JamesTipton/WordClock/Design/Word Clock.xlsx

Sheet: LED Words
Word | Length | Series Voltage | Lights | LED Chip Code | 2 LED | 3 LED | 4 LED | RGB Words | Lights
One | 3 | 8.1 | 3 | 0x00 04 00 00 00 00 |  | 1 |  | Happy | 5
Two | 3 | 8.1 | 3 | 0x00 00 04 00 00 00 |  | 1 |  | Birthday | 8
Three | 5 | 13.5 | 5 | 0x00 00 10 00 00 01 | 1 | 1 |  | Michael | 7
Four | 4 | 10.8 | 4 | 0x00 00 00 00 04 00 |  |  | 1 | Channels | LEDs | Current Draw (@20mA)
Fivebot | 4 | 10.8 | 4 | 0x00 00 00 00 20 00 |  |  | 1 | 3 | 20 | 0.4
Six | 3 | 8.1 | 3 | 0x00 02 00 00 00 00 |  | 1
Seven | 5 | 13.5 | 5 | 0x00 20 00 00 00 02 | 1 | 1
Eight | 5 | 13.5 | 5 | 0x00 08 00 00 00 04 | 1 | 1
Nine | 4 | 10.8 | 4 | 0x00 00 00 00 01 00 |  |  | 1
Tenbot | 3 | 8.1 | 3 | 0x00 00 08 00 00 00 |  | 1
Eleven | 6 | 16.2 | 6 | 0x00 10 20 00 00 00 |  | 2
Twelve | 6 | 16.2 | 6 | 0x00 00 42 00 00 00 |  | 2 |  | TLC5916 Parameters
Oclock | 6 | 16.2 | 6 | 0x00 80 01 00 00 00 |  | 2 |  | Vdd | 5 | V
It Is | 4 | 10.8 | 4 | 0x00 00 00 02 00 00 |  |  | 1 | Vg | 0.992
Tentop | 3 | 8.1 | 3 | 0x00 01 00 00 00 00 |  | 1 |  | CM | 1
Half | 4 | 10.8 | 4 | 0x00 00 00 00 40 00 |  |  | 1 | Io | 0.03 | A
A Quarter | 8 | 21.6 | 8 | 0x00 00 00 01 80 00 |  |  | 2 | Rext | 625 | Ohms
Twenty | 6 | 16.2 | 6 | 0x00 40 80 00 00 00 |  | 2
Fivetop | 4 | 10.8 | 4 | 0x00 00 00 00 02 00 |  |  | 1
Minutes | 7 | 18.9 | 7 | 0x01 00 00 00 10 00 |  | 1 | 1
Past | 4 | 10.8 | 4 | 0x00 00 00 00 08 00 |  |  | 1
To | 2 | 5.4 | 2 | 0x00 00 00 00 00 08 | 1
V Drop Per LED | 2.7 | 7.29 | 99 | Channels | 4 | 17 | 10
Total Words | 22 | Total Channels | 31 | Chips | 1 | 3 | 2
Pinout MSB
Pin | 3LED3 | 3LED2 | 3LED1 | 4LED2 | 4LED1 | 2LED | 48 bits
0 | TES | TENtop | OCL | AQUA | NINE | EE
1 | 0 | SIX | LVE | IT IS | FIVEtop | EN
2 | 0 | ONE | TWO | 0 | FOUR | HT
3 | 0 | EIG | TENbot | 0 | PAST | TO
4 | 0 | ELE | THR | 0 | MINU | 0
5 | 0 | SEV | VEN | 0 | FIVEbot | 0
6 | 0 | TWEtop | TWEbot | 0 | HALF | 0
7 | 0 | OCK | NTY | 0 | RTER | 0
2.833333333

Sheet: Parts List
Nomenclature | Qty | Total Cost | Part Number | Source | Cost Each | Vendor PN | Vendor
Arduino Uno | 1 | 24.95 | Arduino Uno R3 | sparkfun.com | 24.95 | DEV-11021 | Arduino
8 Ch SPI Control LED Driver | 6 | 9.9 | 296-24383-5-ND | digikey.com | 1.65 | TLC5916IN | TI | x
White Clear LED 5mm | 120 | 26.4 |  | evilmadscientist.com | 0.22 | BL-L513UWC | Betlux Electronics
RGB Addressable, PTH | 5 | 14.75 | COM-12999 | sparkfun.com | 2.95 | APA-106-F5 | sparkfun.com
Momentary Pushbutton - White | 4 | 19.8 | COM-11967 | sparkfun.com | 4.95 | COM-11967 | sparkfun.com
Real Time Clock | 1 | 6.03 | DS1305+-ND | digikey.com | 6.03 | DS1305+ | Maxim Integrated | x
32.768kHz Quartz Oscillator | 1 | 0.3 | 728-1000-ND | digikey.com | 0.3 | VT200F-6PF20PPM | Seiko Instruments | x
620 Ohm 2W Resistor | 6 | 1.74 | 620W-2-ND | digikey.com | 0.29 | RSF200JB-73-620R | Yageo | x
12V to 9V Regulator | 1 | 0.7 | LM7809ACT-ND | digikey.com | 0.7 | LM7809ACT | Fairchild Semiconductor | x
12V to 5V Regulator | 1 | 10.84 | 102-2188-ND | digikey.com | 10.84 | V7805-2000R | CUI Inc
12V - 2A Wall Plug | 1 | 13.6 | T1071-P5P-ND | digikey.com | 13.6 | EPSA120200U-P5P-SZ | CUI Inc | x
DC power Plug | 1 | 1.79 | CP3-002AH-ND | digikey.com | 1.79 | PP3-002AH | CUI Inc | x
DC Power Jack | 1 | 2.84 | CP-024A-ND | digikey.com | 2.84 | PR-002A | CUI Inc | x
Capacitor 0.33 uF | 2 | 0.5 | 493-10465-1-ND | digikey.com | 0.25 | UMA1HR33MDD1TP | Nichicon
Capacitor 0.1 uF | 2 | 1.06 | 493-10331-1-ND | digikey.com | 0.53 | UMV1H0R1MFD1TP | Nichicon
Capacitor 1000 uF | 1 | 0.33 | 493-1467-ND | digikey.com | 0.33 | UHE0J102MPD | Nichicon
Coin Battery Holder for RTC - CR2032 Size | 1 | 0.64 | 952-1737-1-ND | digikey.com | 0.64 | S8421-45R | Harwin Inc | x
10k Ohm Resistor | 10 | 0.8 | CF14JT10K0CT-ND | digikey.com | 0.08 | CF14JT10K0 | Stackpole Electronics | x
420 Ohm Resistor | 10 | 1 | CF14JT200RCT-ND | digikey.com | 0.1 | CF14JT200R | Stackpole Electronics
3V Coin Batt for RTC - CR2032 | 1 | 0.28 | P189-ND | digikey.com | 0.28 | CR2032 | Panasonic
1x6 0.1" Pin Header | 2 | 0.84 | 3M9451-ND | digikey.com | 0.42
2x7 0.1" DIP Cable | 1 | 1.74 | H2MXH-1418M | digikey.com | 1.74 |  | Assmann WSW Components
2x10 0.1" DIP Cable | 1 | 2.28 | H2MXH-2018M | digikey.com | 2.28 |  | Assmann WSW Components
7.1" x 7.1"x 0.118" Acrylic Sheet - Clear Film Masked (PMMA) | 2 | 8.52 | Cut to Size | interstateplastics.com | 4.26 | Acrylic Sheet - Clear Film Masked (PMMA) | interstate plastics
7.1" x 7.1"x 0.118" Acrylic Sheet - White 2447 / WRT31 Extruded Paper-Masked (Translucent 55%) | 1 | 6.59 | Cut to Size | interstateplastics.com | 6.59 | ACRYLIC SHEET - WHITE 2447 / WRT31 EXTRUDED PAPER-MASKED (TRANSLUCENT 55%) 55% Light Transmission, Translucent PMMA, Poly(methyl methacrylate) | interstate plastics
Laser Cut Front - Birch (Michael) | 1 | 24 |  | ponoko.com | 24
Laser Cut Front - Cherry (Dad) | 0 | 0 |  | ponoko.com
LED Board 0.25" Ply/MDF | 1 | 1.59 | 131138 | woodcraft.com | 1.59 | 3mmx12"x12" Baltic Birch
Border Wood | 1 | 26.99 | 0.5"x5"x48" Walnut | rockler.com | 26.99
Mounting Screws | 8 | 1.232 | 36-9502-ND | digikey.com | 0.154 | Flat Slotted 4-40 0.5" Screw | Keystone Electronics
Mounting Standoffs | 8 | 2.0128 | 952-1962-ND | digikey.com | 0.2516 | 0.25" 4-40 thread spacer | Harwin Inc
Mounting Standoff Nuts | 8 | 0.592 | 36-4694-ND | digikey.com | 0.074 | 4-40 nut | Keystone Electronics
Total Projected Cost: | 214.6368

Sheet: Laser Cut Layout
I | T |  | I | S |  | A |  | T | E | N |  | I | T |  | I | S | T | E | N | H | A | L | F
T | W | E | N | T | Y |  | H | A | L | F |  | T | W | E | N | T | Y |  | A | F | I | V | E
F | I | V | E |  | Q | U | A | R | T | E | R | H | A | P | P | Y | Q | U | A | R | T | E | R
H | A | P | P | Y | M | I | N | U | T | E | S | B | I | R | T | H | M | I | N | U | T | E | S
B | I | R | T | H |  | T | O | P | A | S | T | D | A | Y | T | O | P | A | S | T | O | N | E
D | A | Y |  | S | I | X |  | O | N | E |  | J | A | M | E | S |  | E | L | E | V | E | N
M | I | C | H | A | E | L |  | F | O | U | R | E | I | G | H | T | S | I | X | F | O | U | R
E | I | G | H | T |  | E | L | E | V | E | N | T | W | O | F | I | V | E | S | E | V | E | N
T | W | O | F | I | V | E | S | E | V | E | N | N | I | N | E | T | H | R | E | E | T | E | N
N | I | N | E | T | H | R | E | E | T | E | N | T | W | E | L | V | E | O | C | L | O | C | K
T | W | E | L | V | E | O | C | L | O | C | K
