JamesTipton/WordClock/PCB/Word Clock.brd

## EAGLE design PCB/Word Clock.brd (2017-01-04)

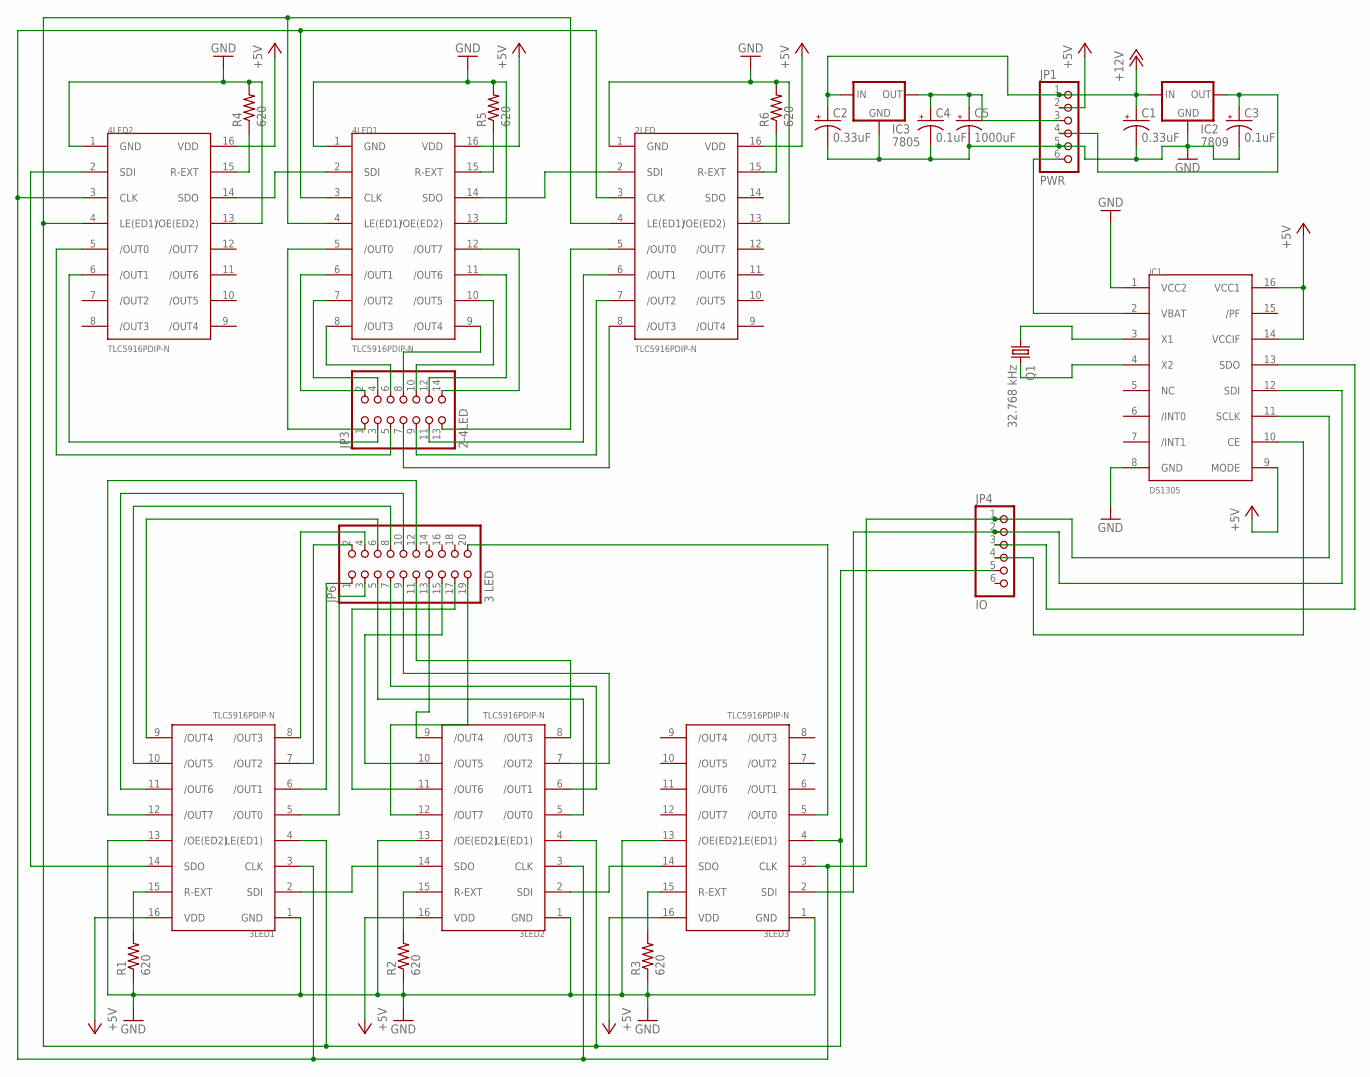
[picture p1: schematic Word Clock.sch]

Parts:
2LED, 3LED1, 3LED2, 3LED3, 4LED1, 4LED2: TLC5916PDIP-N; DIL16
C1, C2: 0.33uF; E2-4
C3, C4: 0.1uF; E2-4
C5: 1000uF; E3,5-8
IC1: DS1305; DIL16
IC2: 7809; 78XXL
IC3: 7805; 78XXL
JP1: PWR; 1X06
JP3: 2-4LED; 2X07
JP4: IO; 1X06
JP6: 3 LED; 2X10
Q1: 32.768 kHz; TC26V
R1, R2, R3, R4, R5, R6: 620; V235/17

Connections:
+5V: 2LED.16 (VDD), 3LED1.16 (VDD), 3LED2.16 (VDD), 3LED3.16 (VDD), 4LED1.16 (VDD), 4LED2.16 (VDD), IC1.9 (MODE), IC1.14 (VCCIF), IC1.16 (VCC1), JP1.2
+12V: C1.+, C2.+, IC2.IN, IC3.IN, JP1.1
GND: 2LED.1 (GND), 2LED.13 (/OE(ED2)), 3LED1.1 (GND), 3LED1.13 (/OE(ED2)), 3LED2.1 (GND), 3LED2.13 (/OE(ED2)), 3LED3.1 (GND), 3LED3.13 (/OE(ED2)), 4LED1.1 (GND), 4LED1.13 (/OE(ED2)), 4LED2.1 (GND), 4LED2.13 (/OE(ED2)), C1.-, C2.-, C3.-, C4.-, C5.-, IC1.1 (VCC2), IC1.8 (GND), IC2.GND, IC3.GND, JP1.5, R1.1, R2.1, R3.1, R4.2, R5.2, R6.2
MISO: IC1.13 (SDO), JP4.3
MOSI: 3LED3.2 (SDI), IC1.12 (SDI), JP4.2
unnamed: IC1.3 (X1), Q1.1
unnamed: IC1.4 (X2), Q1.2
unnamed: 2LED.5 (/OUT0), JP3.13
unnamed: 2LED.6 (/OUT1), JP3.11
unnamed: IC1.2 (VBAT), JP1.6
unnamed: 2LED.7 (/OUT2), JP3.9
unnamed: C4.+, C5.+, IC3.OUT, JP1.3
unnamed: C3.+, IC2.OUT, JP1.4
unnamed: 2LED.8 (/OUT3), JP3.7
unnamed: 4LED1.12 (/OUT7), JP3.14
unnamed: 4LED1.11 (/OUT6), JP3.12
unnamed: 4LED1.10 (/OUT5), JP3.10
unnamed: 4LED1.9 (/OUT4), JP3.8
unnamed: 4LED1.8 (/OUT3), JP3.6
unnamed: 4LED1.7 (/OUT2), JP3.4
unnamed: 4LED1.6 (/OUT1), JP3.2
unnamed: 4LED1.5 (/OUT0), JP3.1
unnamed: 4LED2.6 (/OUT1), JP3.3
unnamed: 4LED2.5 (/OUT0), JP3.5
unnamed: 2LED.2 (SDI), 4LED1.14 (SDO)
unnamed: 4LED1.2 (SDI), 4LED2.14 (SDO)
unnamed: 3LED1.12 (/OUT7), JP6.12
unnamed: 3LED1.7 (/OUT2), JP6.2
unnamed: 3LED1.8 (/OUT3), JP6.4
unnamed: 3LED1.9 (/OUT4), JP6.6
unnamed: 4LED2.15 (R-EXT), R4.1
unnamed: 4LED1.15 (R-EXT), R5.1
unnamed: 2LED.15 (R-EXT), R6.1
unnamed: 3LED1.10 (/OUT5), JP6.8
unnamed: 3LED1.11 (/OUT6), JP6.10
unnamed: 3LED2.5 (/OUT0), JP6.5
unnamed: 3LED3.5 (/OUT0), JP6.20
unnamed: 3LED2.6 (/OUT1), JP6.7
unnamed: 3LED2.7 (/OUT2), JP6.9
unnamed: 2LED.4 (LE(ED1)), 3LED1.4 (LE(ED1)), 3LED2.4 (LE(ED1)), 3LED3.4 (LE(ED1)), 4LED1.4 (LE(ED1)), 4LED2.4 (LE(ED1)), JP4.5
unnamed: 3LED1.6 (/OUT1), JP6.1
unnamed: 3LED1.5 (/OUT0), JP6.3
unnamed: 3LED2.8 (/OUT3), JP6.11
unnamed: 3LED2.9 (/OUT4), JP6.13
unnamed: 3LED2.10 (/OUT5), JP6.15
unnamed: 3LED2.11 (/OUT6), JP6.17
unnamed: 3LED2.12 (/OUT7), JP6.19
unnamed: 3LED2.2 (SDI), 3LED3.14 (SDO)
unnamed: 3LED1.2 (SDI), 3LED2.14 (SDO)
unnamed: 3LED1.14 (SDO), 4LED2.2 (SDI)
unnamed: 3LED3.15 (R-EXT), R3.2
unnamed: 3LED2.15 (R-EXT), R2.2
unnamed: 3LED1.15 (R-EXT), R1.2
SDI_CLK: 2LED.3 (CLK), 3LED1.3 (CLK), 3LED2.3 (CLK), 3LED3.3 (CLK), 4LED1.3 (CLK), 4LED2.3 (CLK), IC1.11 (SCLK), JP4.1
SS_RTC: IC1.10 (CE), JP4.4

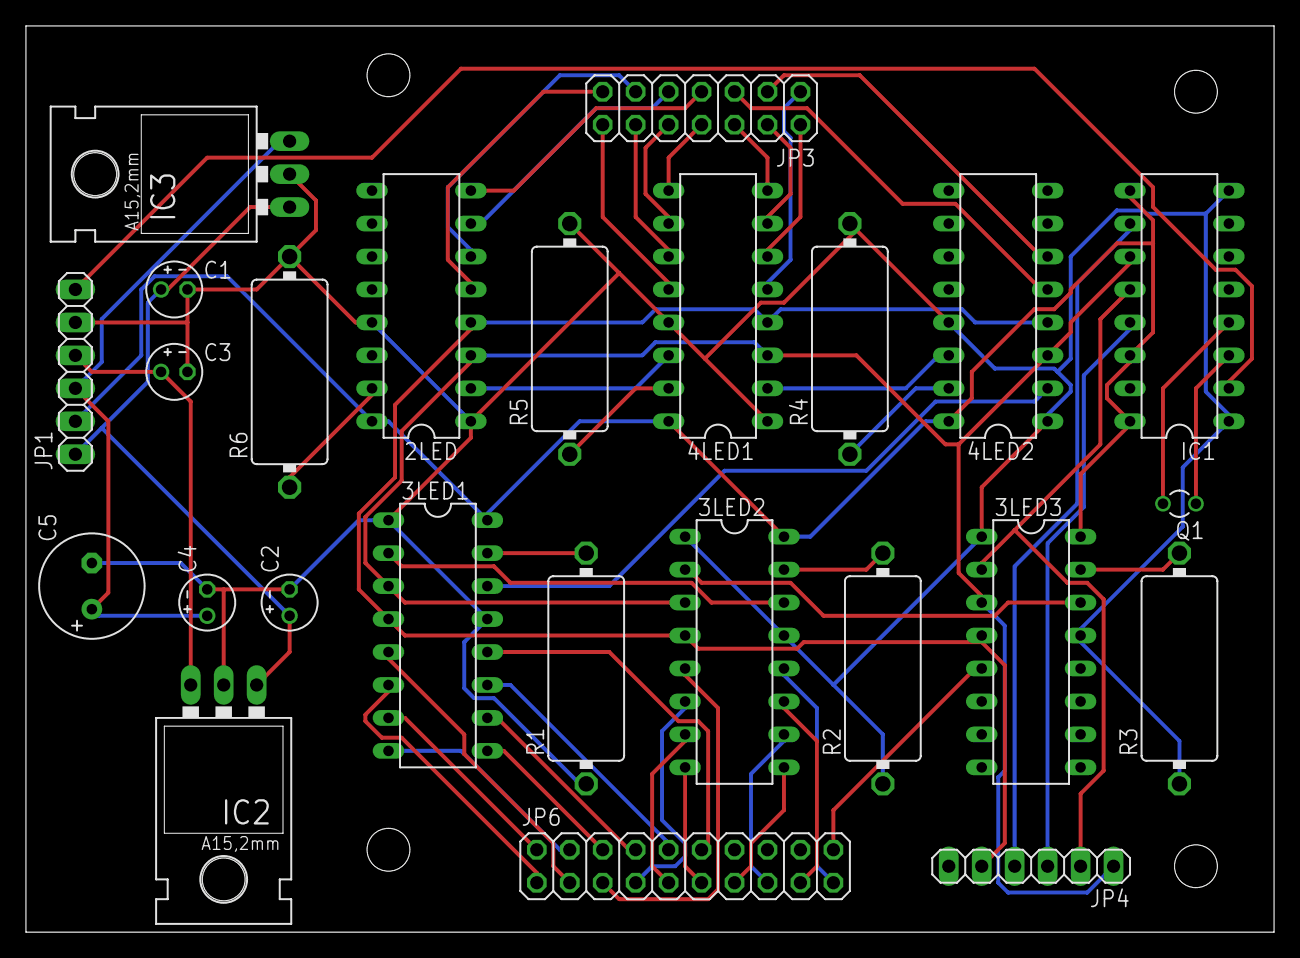
[picture p2: board Word Clock.brd from above]

Board: 2 copper layers, 96.2 x 69.8 mm, 25 parts (0 on the bottom side), 55 nets.
