JamesTipton/WordClock/Code/COM12999_NeoPixel.h

/*--------------------------------------------------------------------
  This file is part of the COM12999 NeoPixel library.

  This has been slightly modified from the Adafruit Neopixel library it is
  derived from.  The COM-12999 Sparkfun 5mm package LED claims WS2812
  compatibility, but it's timing is substantially different.  Changes
  have been made to this library to correct that timing for a 16 MHz
  AVR running an 800 kHz stream.  The librarys have been renamed from
  Adafruit librarys so that existing installations of Adafruit libraries
  will still function, but the differences can be used.

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
  You should have received a copy of the GNU Lesser General Public
  License along with NeoPixel.  If not, see
  <http://www.gnu.org/licenses/>.
  --------------------------------------------------------------------*/

#ifndef COM12999_NEOPIXEL_H
#define COM12999_NEOPIXEL_H

#if (ARDUINO >= 100)
 #include <Arduino.h>
#else
 #include <WProgram.h>
 #include <pins_arduino.h>
#endif

// 'type' flags for LED pixels (third parameter to constructor):
#define NEO_RGB     0x00 // Wired for RGB data order
#define NEO_GRB     0x01 // Wired for GRB data order
#define NEO_BRG     0x04
  
#define NEO_COLMASK 0x01
#define NEO_KHZ800  0x02 // 800 KHz datastream
#define NEO_SPDMASK 0x02
// Trinket flash space is tight, v1 NeoPixels aren't handled by default.
// Remove the ifndef/endif to add support -- but code will be bigger.
// Conversely, can comment out the #defines to save space on other MCUs.
#ifndef __AVR_ATtiny85__
#define NEO_KHZ400  0x00 // 400 KHz datastream
#endif

class COM12999_NeoPixel {

 public:

  // Constructor: number of LEDs, pin number, LED type
  COM12999_NeoPixel(uint16_t n, uint8_t p=6, uint8_t t=NEO_GRB + NEO_KHZ800);
  ~COM12999_NeoPixel();

  void
    begin(void),
    show(void),
    setPin(uint8_t p),
    setPixelColor(uint16_t n, uint8_t r, uint8_t g, uint8_t b),
    setPixelColor(uint16_t n, uint32_t c),
    setBrightness(uint8_t);
  uint8_t
   *getPixels(void) const;
  uint16_t
    numPixels(void) const;
  static uint32_t
    Color(uint8_t r, uint8_t g, uint8_t b);
  uint32_t
    getPixelColor(uint16_t n) const;

 private:

  const uint16_t
    numLEDs,       // Number of RGB LEDs in strip
    numBytes;      // Size of 'pixels' buffer below
  uint8_t
    pin,           // Output pin number
    brightness,
   *pixels,        // Holds LED color values (3 bytes each)
    rOffset,       // Index of red byte within each 3-byte pixel
    gOffset,       // Index of green byte
    bOffset;       // Index of blue byte
  const uint8_t
    type;          // Pixel flags (400 vs 800 KHz, RGB vs GRB color)
  uint32_t
    endTime;       // Latch timing reference
#ifdef __AVR__
  const volatile uint8_t
    *port;         // Output PORT register
  uint8_t
    pinMask;       // Output PORT bitmask
#endif

};

#endif // COM12999_NEOPIXEL_H
